ProtonKicker/Flourine/media/v1 dec 18 2024.jpg

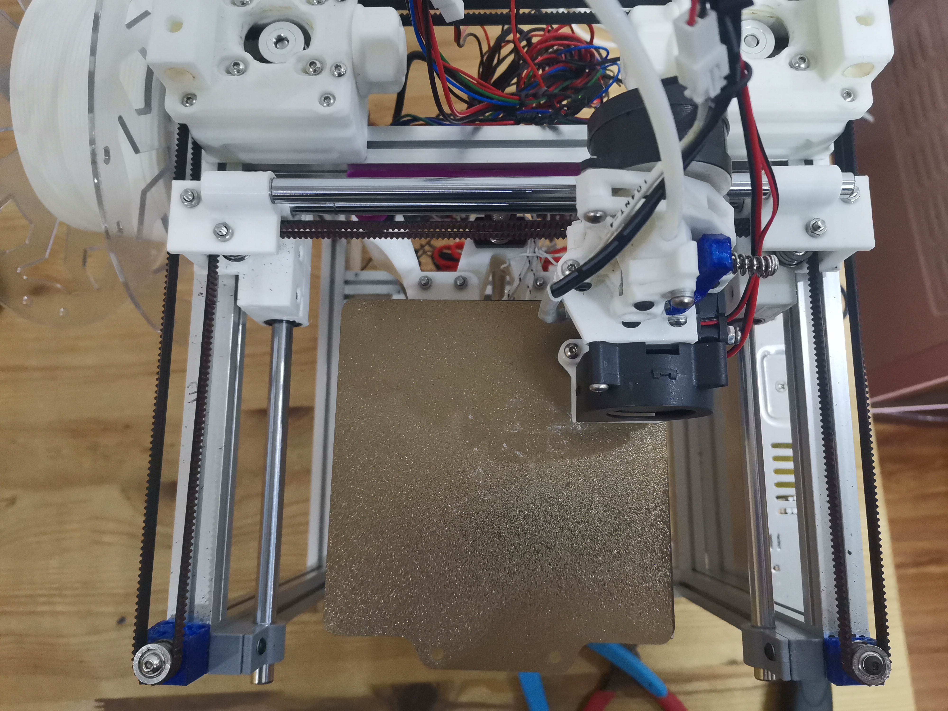
media/v1 dec 18 2024.jpg
