ProtonKicker/Flourine/media/v1 jul 18 2025.jpg

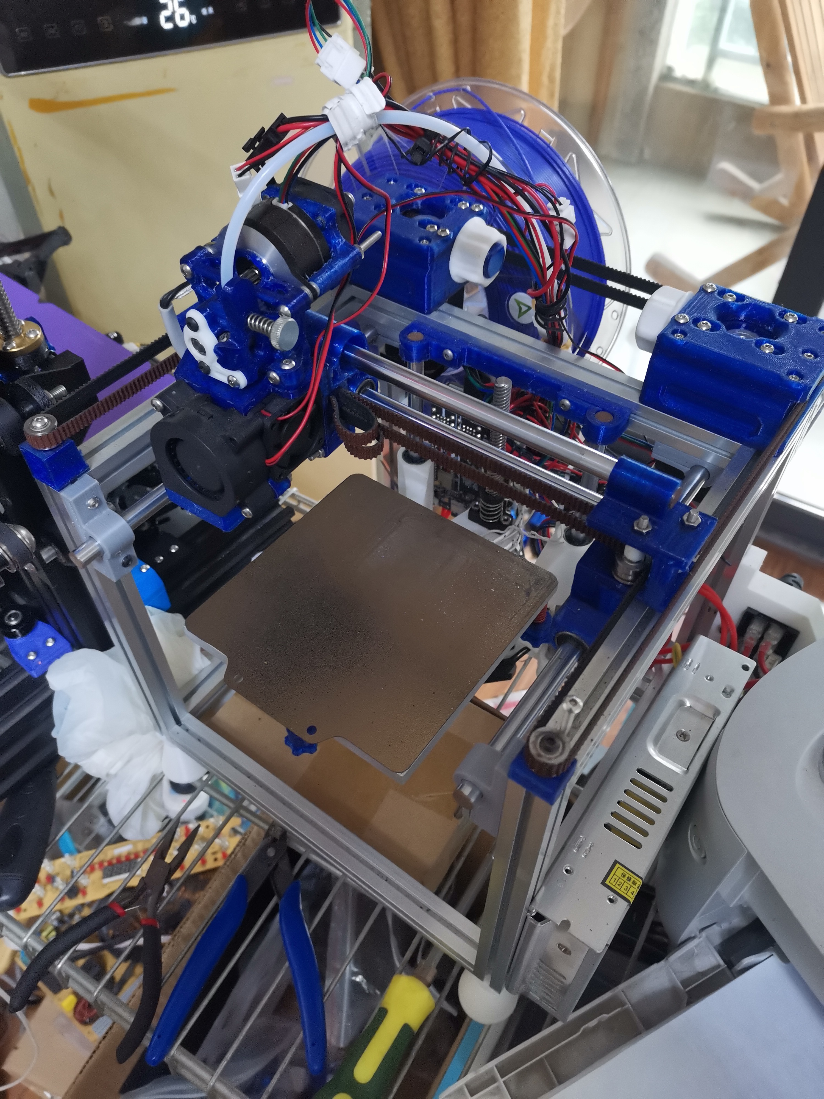
media/v1 jul 18 2025.jpg
