ProtonKicker/Flourine/siboor voron 0 motor kit specs/README.md

info about the motors I used in this build
