ProtonKicker/Flourine/hotend size (chc)/README.md

Here are the infomation for the hotend I used

Any hotend with a heatsink diameter no larger than 22mm and 4 M2.5 holes on top is fine.

You can adjust the air duct depth using the CAD files if your hotend features a different length
