ProtonKicker/Flourine/toolhead variant - orbiter v2.5/README.md

#### Oribter v2.5 Toolhead Variant

Print the adapter, update the gear ratio, and you're good to go
