ProtonKicker/Flourine/hotend size (chc)/size1.png

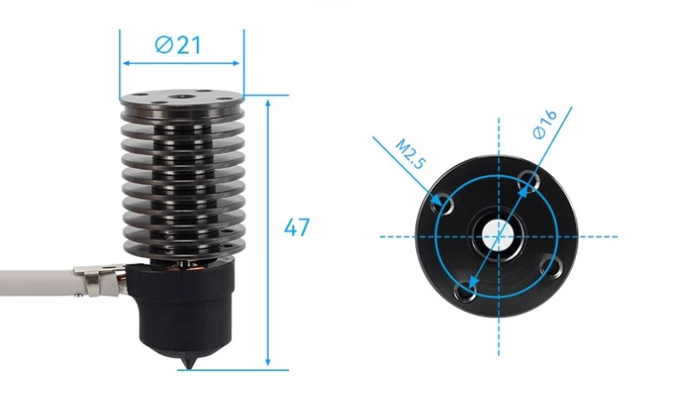
hotend size (chc)/size1.png
