ProtonKicker/Flourine/hotend size (chc)/size 2.png

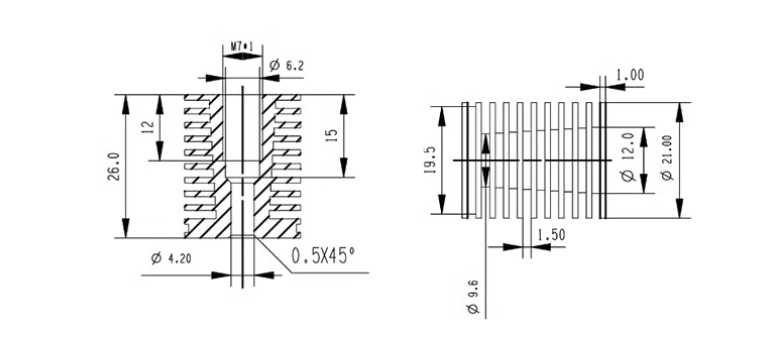
hotend size (chc)/size 2.png
