ProtonKicker/Flourine/media/v1 dec 31 2024.jpg

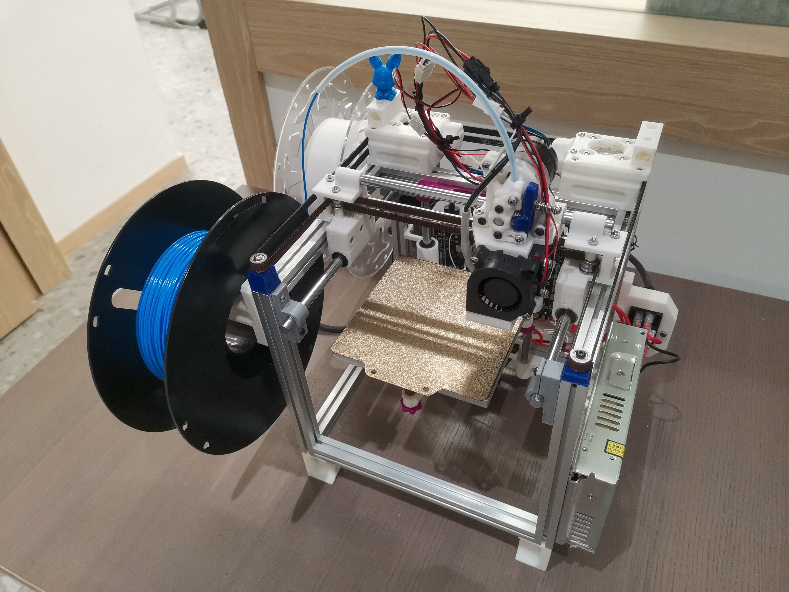
media/v1 dec 31 2024.jpg
