ProtonKicker/Flourine/media/xy motion snapshot.png

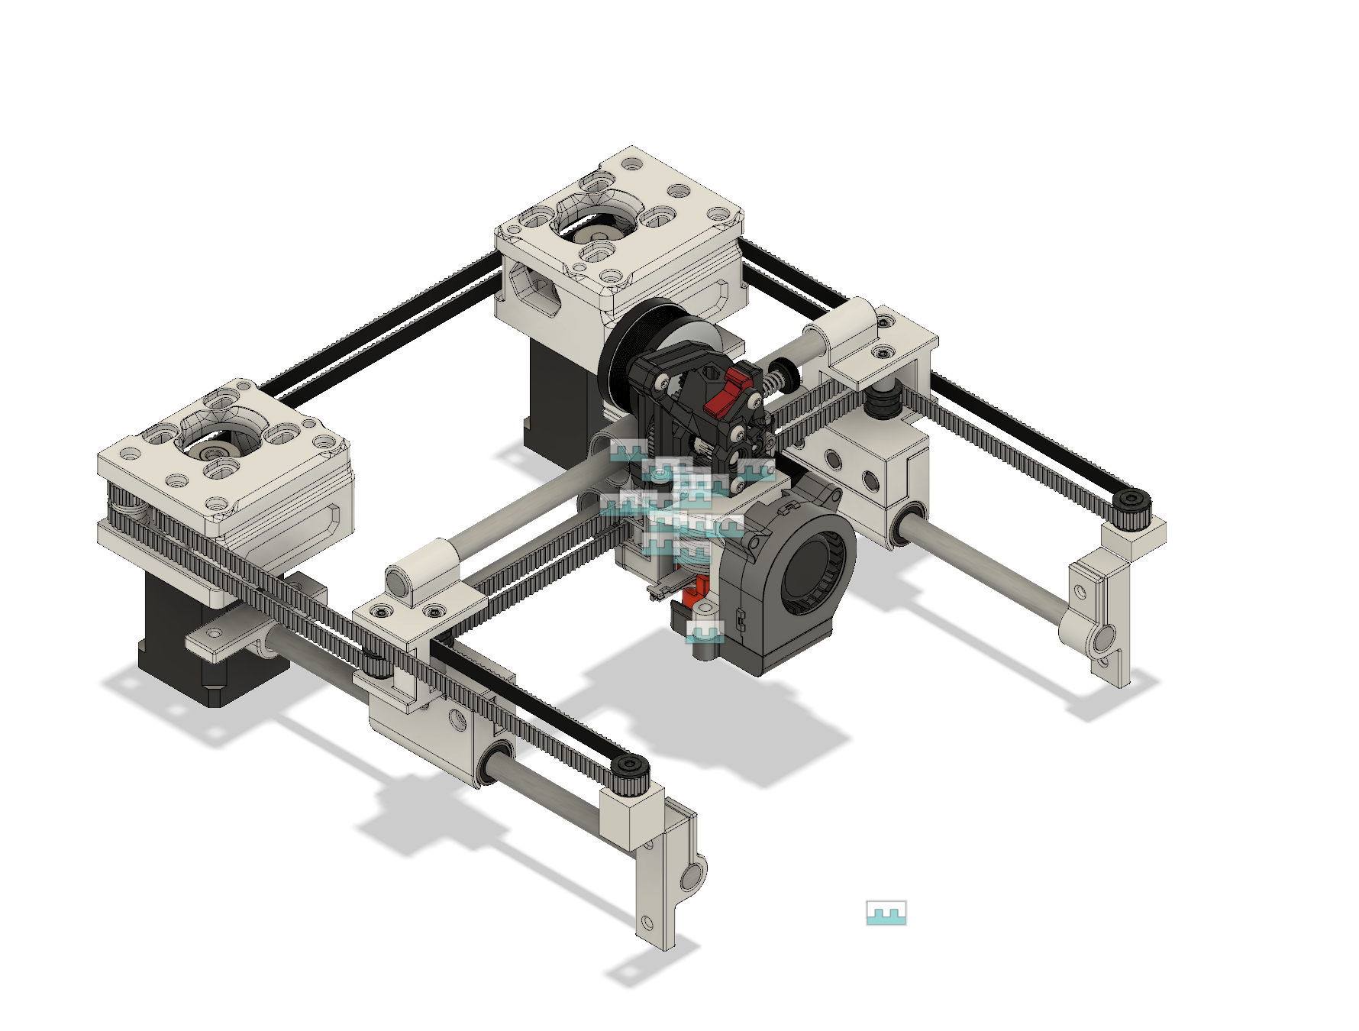
media/xy motion snapshot.png
