ProtonKicker/Flourine/siboor voron 0 motor kit specs/pancake motor.jpg

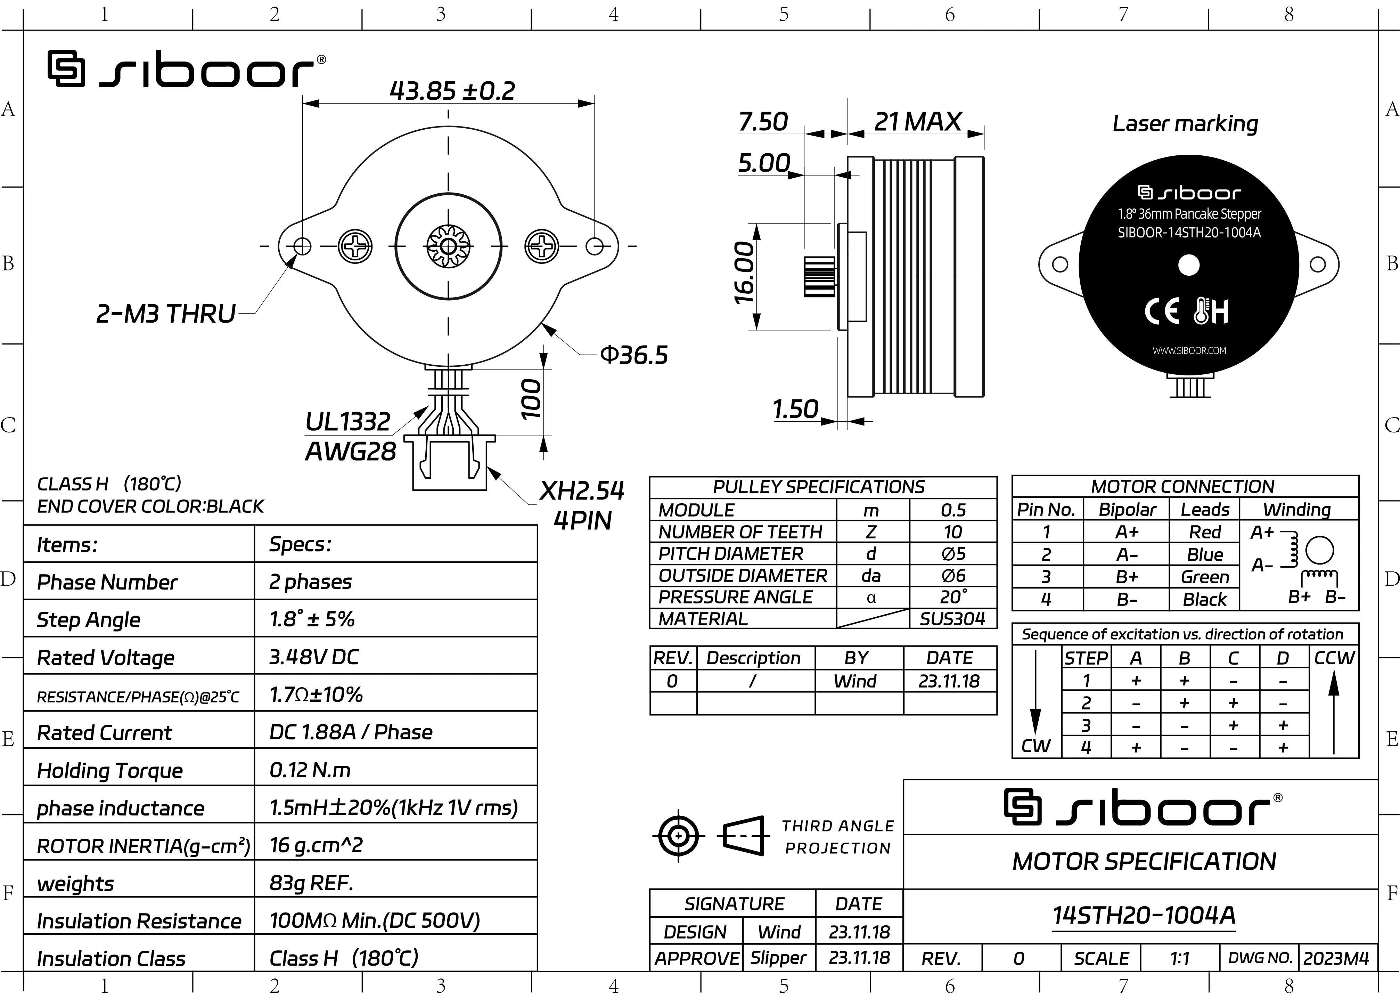
siboor voron 0 motor kit specs/pancake motor.jpg
