ProtonKicker/Flourine/siboor voron 0 motor kit specs/xy motor.jpg

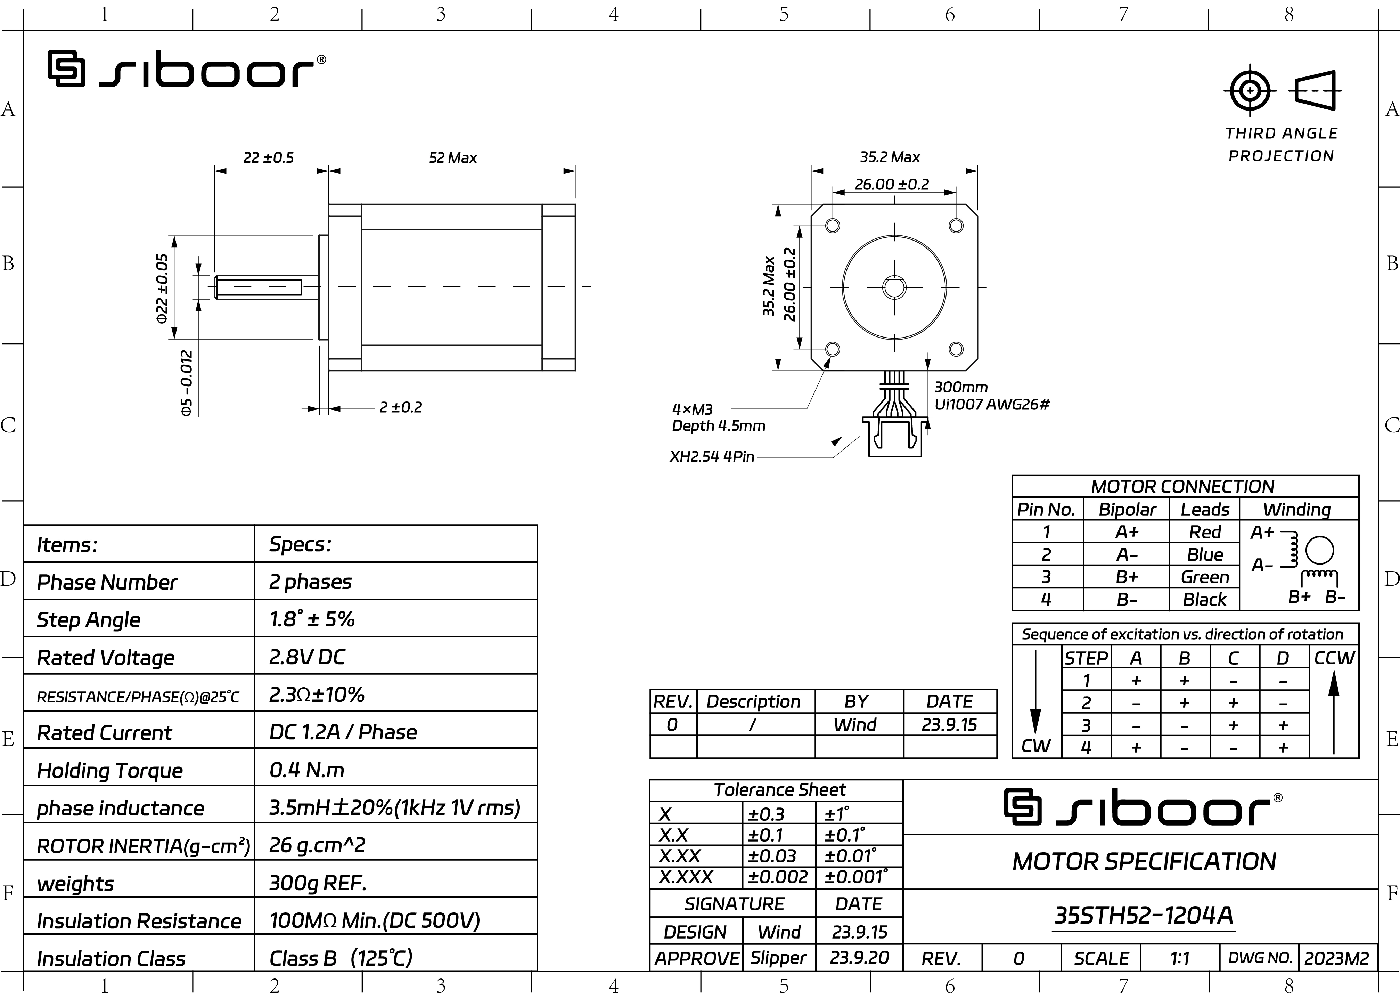
siboor voron 0 motor kit specs/xy motor.jpg
