ProtonKicker/Flourine/siboor voron 0 motor kit specs/z motor.jpg

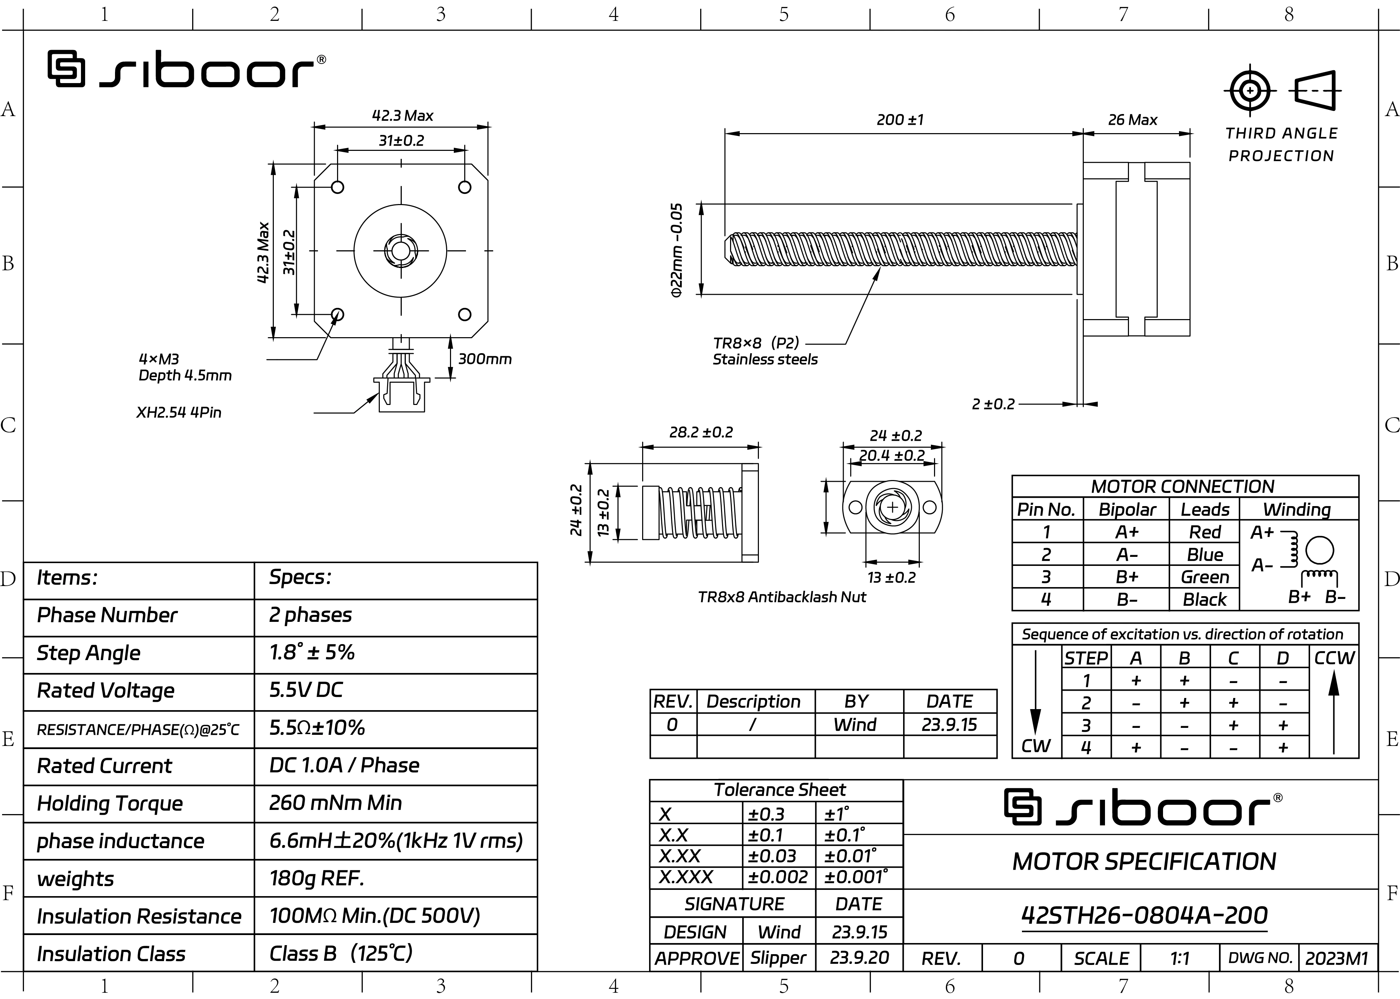
siboor voron 0 motor kit specs/z motor.jpg
