ProtonKicker/Flourine/toolhead variant - orbiter v2.5/new toolhead variant with LDO orbitor v2.5.png

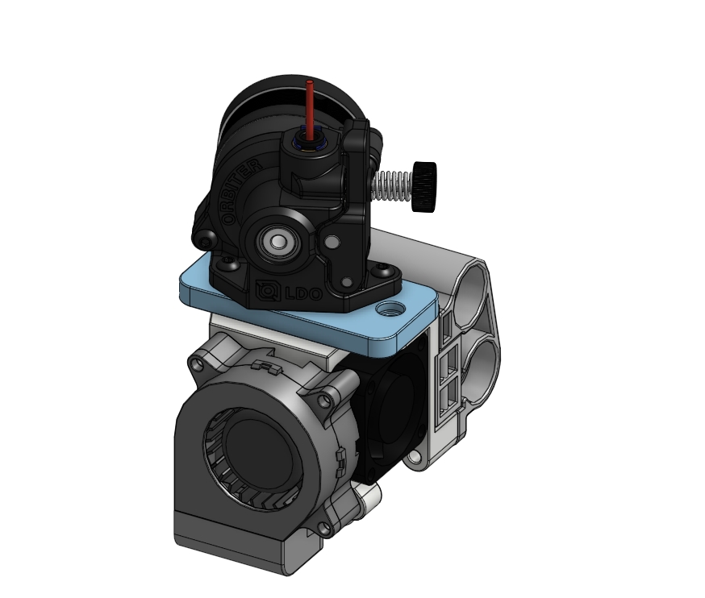
toolhead variant - orbiter v2.5/new toolhead variant with LDO orbitor v2.5.png
