ProtonKicker/Flourine/toolhead variant - orbiter v2.5/toolhead with v2.5.jpg

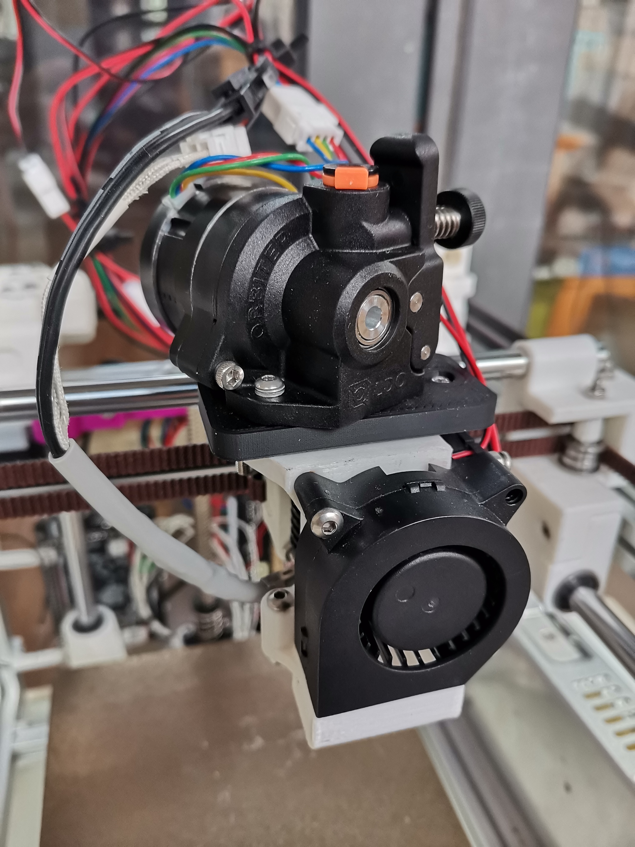
toolhead variant - orbiter v2.5/toolhead with v2.5.jpg
