ProtonKicker/Flourine/cost calculations/bills.xlsx

item name | amount | total price in CNY | percent
voron 0 extrusion kit (tapped) | 1 | 100.9 | 0.13719491467808825
extruder gear kit | 1 | 15 | 0.020395676116663267
micro switch | 10 | 2.2 | 0.002991365830443946
v6 voron hotend | 1 | 73.5 | 0.09993881297165001
skr pico & btt pi | 1 | 254 | 0.34536678224216466
sibor motor kit | 1 | 155.53 | 0.21147596709497588
sibor pancake motor extension cable | 1 | 1.49 | 0.0020259704942552177
16 awg cable | 2 meters | 2.12 | 0.0028825888911550752
steal rod 20cm | 6 | 21.5 | 0.029233802433884015
smooth rod bearing | 6 | 6.41 | 0.00871575226052077
idler bearing | 24 | 24 | 0.03263308178666123
6mm timing belt | 2 | 10.08 | 0.013705894350397716
20 tooth pulley for xy motors | 2
12*12cm glass | 1 | 7.82 | 0.010632945815487117
bed springs | 4 | 2.3 | 0.0031273370045550343
24V 4020 blower fan | 1 | 2.82 | 0.0038343871099326943
meanwell 150w power supply | 1 | 49 | 0.06662587531443334
iec c14 plug | 1 | 5.99 | 0.008144673329254198
heat shrink tubing 2mm | 5 meters | 0.79 | 0.0010741722754775988
 | total spending | 735.45
 | total spending in USD | 103.43881856540085
