ProtonKicker/Flourine/toolhead variant - orbiter v2.5/adapter print file/LDO Oribiter Extruder v2.5 to Sherpa Mini Holes Adapter.step

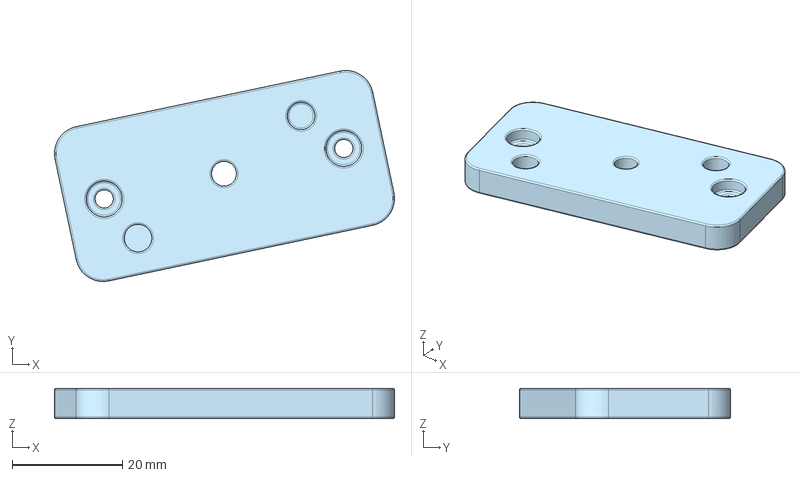
[picture p12: CAD file, 2025-01-07]
toolhead variant - orbiter v2.5/adapter print file/LDO Oribiter Extruder v2.5 to Sherpa Mini Holes Adapter.step
61.7 x 38.3 x 5.50 mm
