ProtonKicker/Flourine/(list of files, cad)

Other CAD files:
toolhead variant - orbiter v2.5/adapter print file/LDO Oribiter Extruder v2.5 to Sherpa Mini Holes Adapter.3mf
