ProtonKicker/Flourine/printer CAD/README.md

Unzip using Windows/Mac defualt zipper for the printer assembly's STEP file.
