ProtonKicker/Flourine/manual & guide/flash SKR Pico firmware-chinese.docx

1. 依次输入

cd klipper

make menuconfig

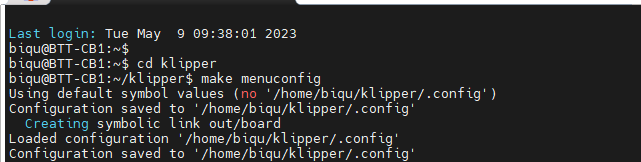
[picture p13: figure]

按照下图进行设置（usb通信）

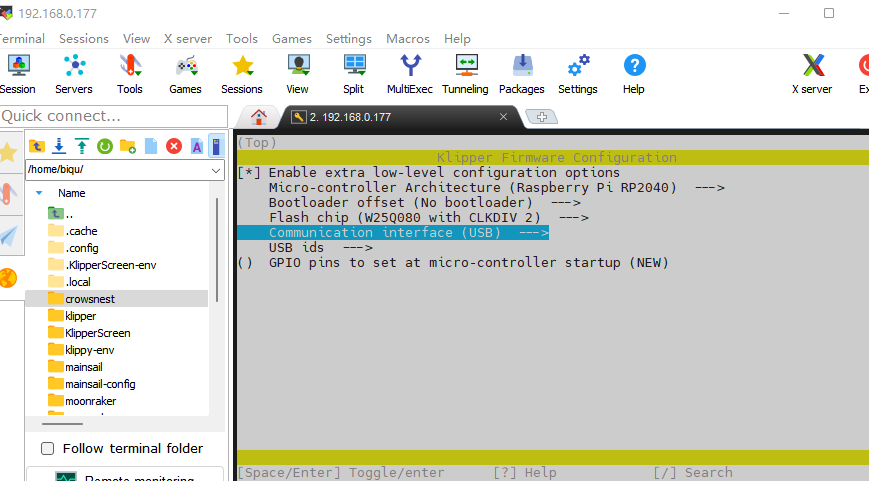
[picture p14: figure]
1683628040394_8f44064431857b506f4989d0278a1748

2.输入make命令

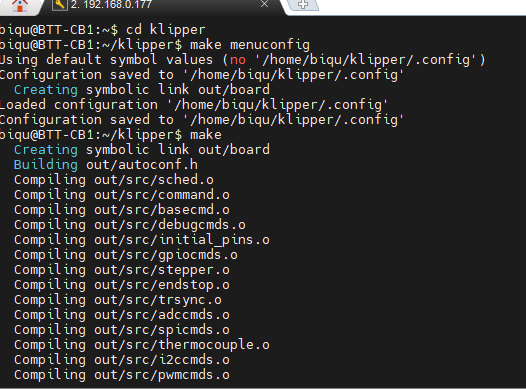
[picture p15: figure]

创建 uf2 文件 out/klipper.uf2

则表示固件编译成功。

3.然后将klipper.uf2下载到您的计算机上。

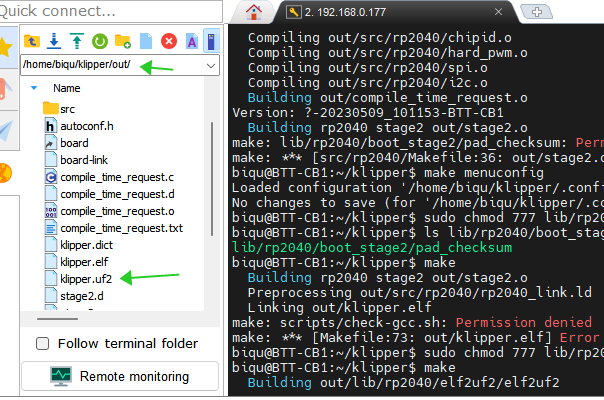
[picture p16: figure]

4.固件安装

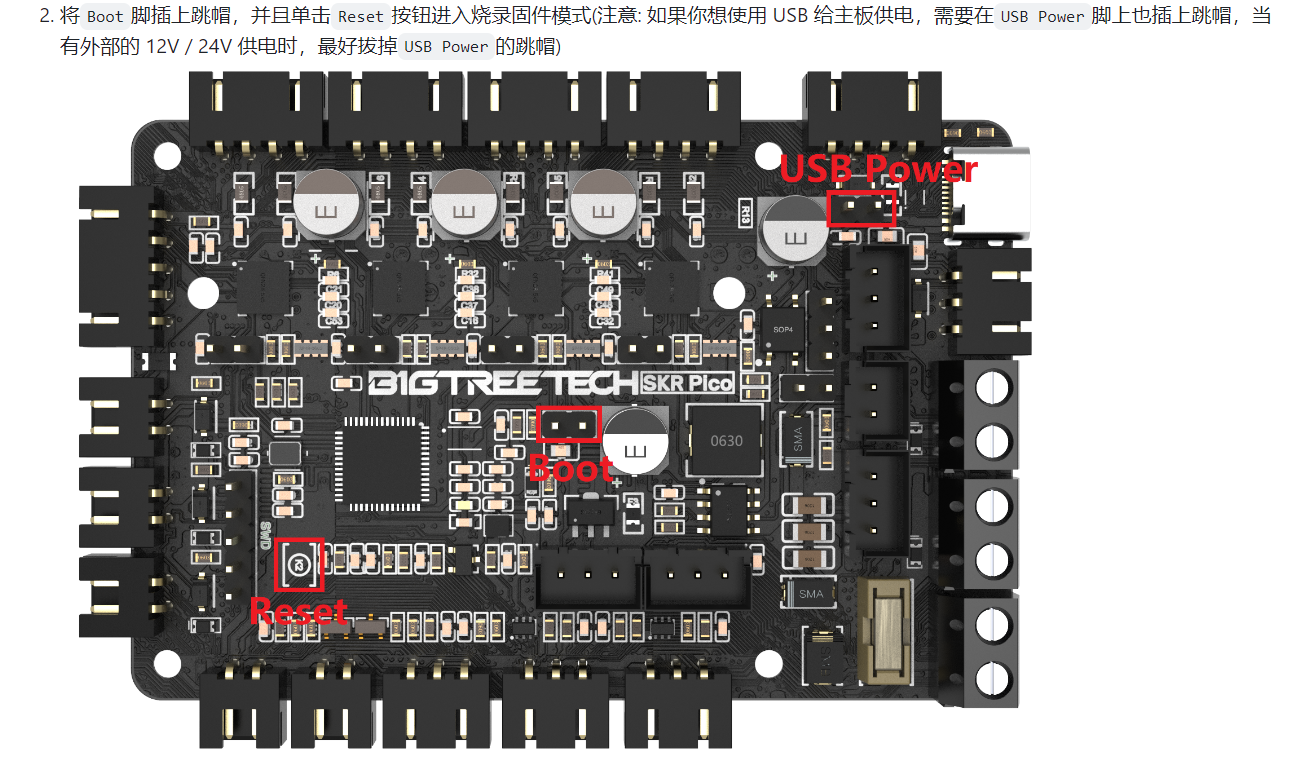
[picture p17: figure]
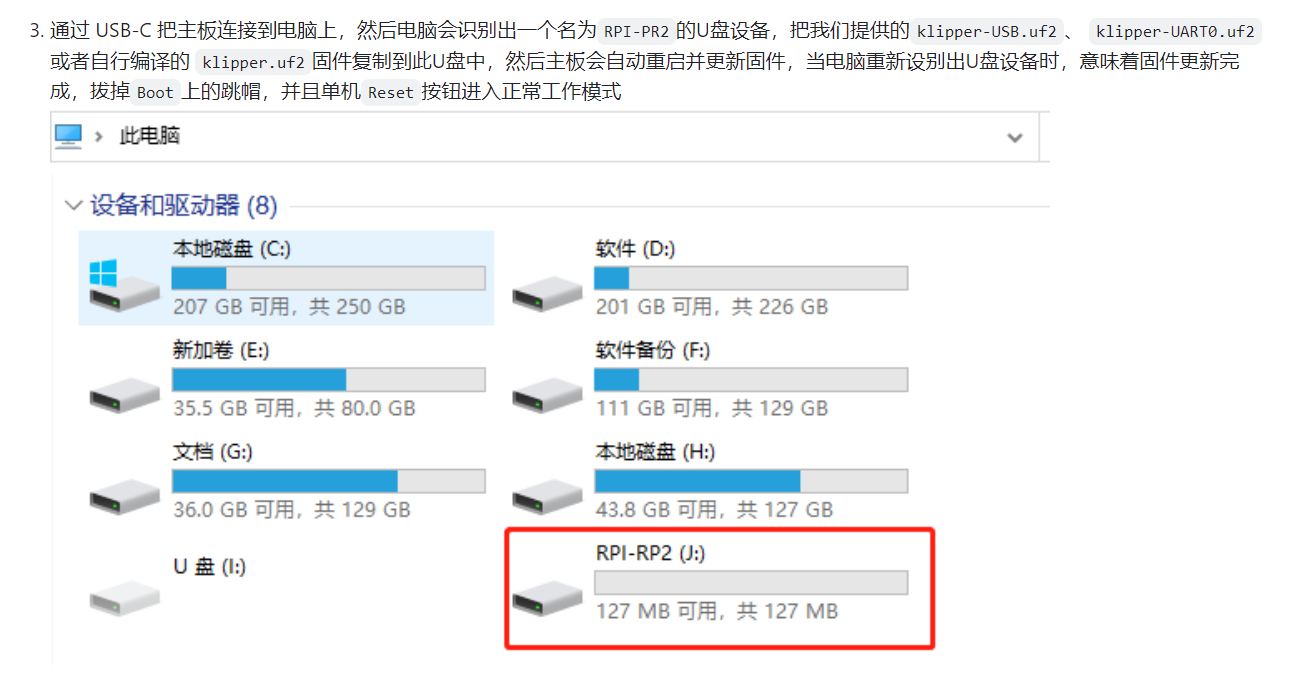
[picture p18: figure]

5.烧录成功后，skr pico拔掉boot跳线帽和usb跳线帽，上位机usb接到skr pico的typec，输入命令ls /dev/serial/by-id来查询主板的串口id（只适用于usb通信）

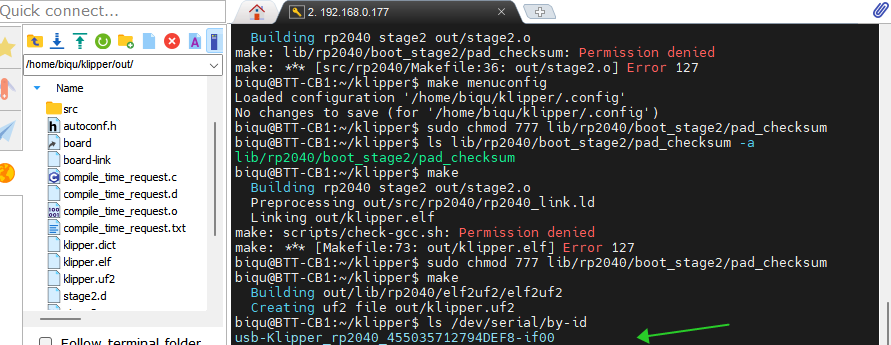
[picture p19: figure]

6.添加配置文件generic-bigtreetech-skr-pico-v1.0.cfg，并引用（include）

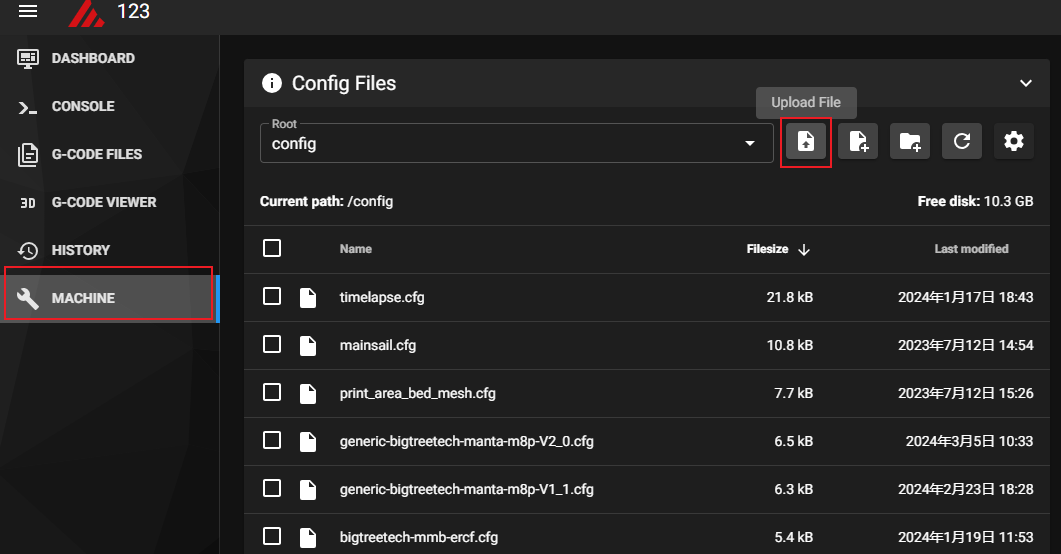
[picture p20: figure]

引用：

在添加的配置文件里找到mcu，并把对应位置改成自己找到的id
