ProtonKicker/Flourine/manual & guide/README.md

### here are the files to guide you through the build
