ProtonKicker/Flourine/manual & guide/setup BTT Pi for SKR Pico by SSH.png

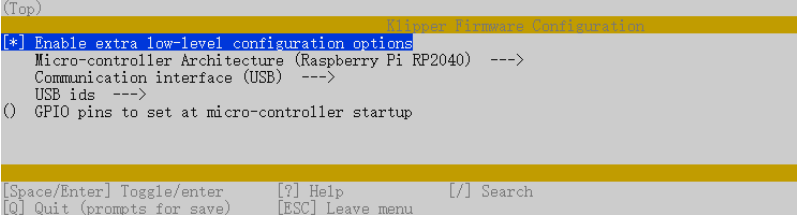
manual & guide/setup BTT Pi for SKR Pico by SSH.png
