ProtonKicker/Flourine/firmwares/printer.cfg

#[virtual_sdcard]
#path: /home/biqu/printer_data/gcodes #/home/biqu/printer_ender3neo_data/gcodes
[exclude_object]
[include mainsail.cfg]

# This file contains common pin mappings for the BIGTREETECH SKR Pico V1.0
# To use this config, the firmware should be compiled for the RP2040 with
# USB communication.

# The "make flash" command does not work on the SKR Pico V1.0. Instead,
# after running "make", copy the generated "out/klipper.uf2" file
# to the mass storage device in RP2040 boot mode

## Voron Design VORON 0.2 SKR Pico V1.0 config

## *** THINGS TO CHANGE/CHECK: ***
## MCU path                                                                     [mcu] section
## Z and Extruder motor currents                                                [tmc2209 stepper_*] sections. Uncomment the stepper motor you have
## Full steps per rotation for Extruder                                         [extruder] section
## Thermistor types                                                             [extruder] and [heater_bed] sections - See https://www.klipper3d.org/Config_Reference.html#common-thermistors for common thermistor types
## Motor currents                                                               [extruder] [stepper] and [_HOME_X/Y] macro sections
## PID tune                                                                     [extruder] and [heater_bed] sections
## Fine tune E steps                                                            [extruder] section
## For more info                                                                check https://docs.vorondesign.com/build/startup/#v0

[mcu]
#####################################################################
# Obtain definition by "ls -l /dev/serial/by-id/"
#####################################################################
serial: /dev/serial/by-id/usb-Klipper_rp2040_454741505A89CADA-if00
## serial: /dev/ttyAMA0 											# for UART connection
restart_method: command


[temperature_sensor mcu_temp]
sensor_type: temperature_mcu
min_temp: 0
max_temp: 80

[temperature_sensor raspberry_pi]
sensor_type: temperature_host
min_temp: 10
max_temp: 80

[printer]
kinematics: corexy
max_velocity: 600
max_accel: 15000
max_z_velocity: 20
max_z_accel: 200
square_corner_velocity: 6.0

#####################################################################
#      X/Y Stepper Settings
#####################################################################

[stepper_x]
step_pin: gpio11
## Refer to https://docs.vorondesign.com/build/startup/#v0
dir_pin: !gpio10                                                     # Check motor direction in link above. If inverted, add a ! before gpio10
enable_pin: !gpio12
rotation_distance: 40
microsteps: 32
full_steps_per_rotation: 200                                        # Set to 400 for 0.9° degree stepper motor, 200 is for 1.8° stepper motors
endstop_pin: tmc2209_stepper_x:virtual_endstop
position_endstop: 120
position_max: 120
homing_speed: 20                                                    # for sensorless homing it is recommended not to go above 40mm/s   
homing_retract_dist: 0
homing_positive_dir: true

[tmc2209 stepper_x]
uart_pin: gpio9
tx_pin: gpio8
uart_address: 0
interpolate: True
run_current: 0.6            
# you need to calculate the run_current value using the equation (rated_motor_current * 0.707 = Maximum_run_current) start with a value that is about 60%-70% of your maximum value.
sense_resistor: 0.110
stealthchop_threshold: 0                                            # Set to 999999 to turn stealthchop on, and 0 to use spreadcycle
diag_pin: ^gpio4    												# YOU NEED TO JUMP THIS DIAG PIN ON YOUR BOARD FOR SENSORLESS HOMING TO WORK 
driver_SGTHRS: 45  												# this is set to 255 which is the MAX sensitivity for sensorless homing, you will need to tune this later

[stepper_y]
step_pin: gpio6
## Refer to https://docs.vorondesign.com/build/startup/#v0
dir_pin: gpio5                                                      # Check motor direction in link above. If inverted, add a ! before gpio5
enable_pin: !gpio7
rotation_distance: 40
microsteps: 32
full_steps_per_rotation: 200                                        # Set to 400 for 0.9° degree stepper motor, 200 is for 1.8° stepper motors
endstop_pin: tmc2209_stepper_y:virtual_endstop
position_endstop: 115
position_max: 120
homing_speed: 20                                                    # for sensorless homing it is recommended not to go above 40mm/s   
homing_retract_dist: 0
homing_positive_dir: true

[tmc2209 stepper_y]
uart_pin: gpio9
tx_pin: gpio8
uart_address: 2
interpolate: True
run_current: 0.6            
# you need to calculate the run_current value using the equation (rated_motor_current * 0.707 = Maximum_run_current) start with a value that is about 60%-70% of your maximum value.
sense_resistor: 0.110
stealthchop_threshold: 0                                            # Set to 999999 to turn stealthchop on, and 0 to use spreadcycle
diag_pin: ^gpio3    												# YOU NEED TO JUMP THIS DIAG PIN ON YOUR BOARD FOR SENSORLESS HOMING TO WORK 
driver_SGTHRS: 60										# this is set to 255 which is the MAX sensitivity for sensorless homing, you will need to tune this later

#####################################################################
#   Z Stepper Settings
#####################################################################

[stepper_z]
step_pin: gpio19
dir_pin: !gpio28                                                    # Remove the ! before gpio28 if motor direction is inverted.
enable_pin: !gpio2
rotation_distance: 8                                                # For T8x8 integrated lead screw
microsteps: 32
endstop_pin: ^gpio25
position_endstop: 100.25
position_max: 130
position_min: 0
homing_speed: 15
second_homing_speed: 3.0
homing_retract_dist: 3.0


[tmc2209 stepper_z]
uart_pin: gpio9
tx_pin: gpio8
uart_address: 1
interpolate: True
## For OMC (StepperOnline) 17LS13-0404E-200G 0.4A 
#run_current: 0.2
## For LDO-42STH25-1004CL200E 1.0A
#run_current: 0.37
run_current: 0.6
sense_resistor: 0.110
stealthchop_threshold: 0                                            # Set to 999999 to turn stealthchop on, and 0 to use spreadcycle

#####################################################################
#   Extruder
#####################################################################

[extruder]
step_pin: gpio14
dir_pin: !gpio13                                                     # Add ! if moving opposite direction
enable_pin: !gpio15
full_steps_per_rotation: 200                                       # Set to 200 for LDO 1.8° stepper motor, and set to 400 for OMC(StepperOnline) 0.9° stepper motor
rotation_distance: 22.23                                            # See calibrating rotation_distance on extruders doc
gear_ratio: 50:10                                                   # For Mini Afterburner
microsteps: 32
nozzle_diameter: 0.400
filament_diameter: 1.750
heater_pin: gpio23
sensor_type: Generic 3950
sensor_pin: gpio27
control: pid                                                        # Do PID calibration after initial checks
pid_Kp: 28.182
pid_Ki: 1.978
pid_Kd: 100.397
min_temp: 0
max_temp: 320
min_extrude_temp: 190
max_extrude_only_distance: 150
max_extrude_cross_section: 0.8
pressure_advance: 0.0                                               # See tuning pressure advance doc
pressure_advance_smooth_time: 0.040

[tmc2209 extruder]
uart_pin: gpio9
tx_pin: gpio8
uart_address: 3
interpolate: True
## For OMC (StepperOnline) 14HR07-1004VRN 1A 0.9°
#run_current: 0.5 # for OMC 14HR07-1004VRN rated at 1A
## For LDO LDO 36STH17-1004AHG 1A 1.8° 
#run_current: 0.3 # for LDO 36STH17-1004AHG
## For LDO LDO 36STH20-1004AHG 1A 1.8° 
#run_current: 0.6 # for LDO 36STH20-1004AHG
run_current: 0.55
sense_resistor: 0.110
stealthchop_threshold: 0                                            # Set to 0 for spreadcycle, avoid using stealthchop on extruder

#####################################################################
#   Bed Heater
#####################################################################

[heater_bed]
heater_pin: gpio21                  # Ensure this matches your wiring

## Using NTC100K sensor, same as the extruder
sensor_type: Generic 3950 # Common NTC100K thermistor type

sensor_pin: gpio26                  # Ensure this matches your wiring
smooth_time: 3.0                    # Adjust as needed

max_power: 0.7                     

min_temp: 0
max_temp: 120
control: pid                        # Do PID calibration after initial checks
pid_kp: 68.453                      # Adjust based on PID tuning
pid_ki: 2.749                       # Adjust based on PID tuning
pid_kd: 426.122                     # Adjust based on PID tuning


#####################################################################
# Fan Control
#####################################################################

[heater_fan hotend_fan]
pin: gpio18
max_power: 1.0
kick_start_time: 0.5
heater: extruder
heater_temp: 30
fan_speed: 1.0                                                     # You can't PWM the delta fan unless using blue wire

[fan]
pin: gpio17
max_power: 1.0
kick_start_time: 0.5                                                # Depending on your fan, you may need to increase this value if your fan will not start
off_below: 0.13
cycle_time: 0.010

[output_pin controller_board_fan]
# Fan connected to GPIO20, configured to be always on when MCU is powered.
pin: gpio20
pwm: False        # Set to True if your fan is PWM controllable and you need speed control, otherwise False for simple on/off. Always-on usually means False.
value: 1          # Set to 1 (ON) by default.
shutdown_value: 0 # Turn OFF when Klipper enters shutdown state.

#####################################################################
#   Filament Runout Sensor
#####################################################################

#[filament_switch_sensor Filament_Runout_Sensor]
#pause_on_runout: True
#runout_gcode: PAUSE
#switch_pin: gpio16

#####################################################################
# Homing and Gantry Adjustment Routines
#####################################################################

[idle_timeout]
timeout: 1800

[homing_override]
axes: xyz
set_position_z: 0
gcode:
   G90
   G0 Z5 F600
  {% set home_all = 'X' not in params and 'Y' not in params and 'Z' not in params %}

  {% if home_all or 'X' in params %}
    _HOME_X
  {% endif %}
  
  {% if home_all or 'Y' in params %}
    _HOME_Y
  {% endif %}
  
  {% if home_all or 'Z' in params %}
    _HOME_Z
  {% endif %}

#[safe_z_home]
##home_xy_position: 120,120 										# these coordinates must NOT be greater than the values specified in "position_max:" for the X and Y steppers
#speed: 50.0
#z_hop: 5

## To be used with BED_SCREWS_ADJUST
[bed_screws]
screw1: 60,5
screw1_name: front screw
screw2: 5,115
screw2_name: back left
screw3: 115,115
screw3_name: back right

#####################################################################
# Neopixel
#####################################################################

[neopixel board_rgb]
pin: gpio24
chain_count: 1
color_order: GRB
initial_RED: 0.0
initial_GREEN: 0.1
initial_BLUE: 0.0

#####################################################################
#   V0 Display
#####################################################################
# [mcu display]
# serial: **PASTE YOUR SERIAL PORT HERE AND UNCOMMENT**
# restart_method: command

# [display]
# lcd_type: sh1106
# i2c_mcu: display
# i2c_bus: i2c1a
# # Set the direction of the encoder wheel
# #   Standard: Right (clockwise) scrolls down or increases values. Left (counter-clockwise scrolls up or decreases values.
# encoder_pins: ^display:PA3, ^display:PA4
# #   Reversed: Right (clockwise) scrolls up or decreases values. Left (counter-clockwise scrolls down or increases values.
# #encoder_pins: ^display:PA4, ^display:PA3
# click_pin: ^!display:PA1
# kill_pin: ^!display:PA5
# #x_offset: 2
# #   Use X offset to shift the display towards the right. Value can be 0 to 3
# #vcomh: 0
# #   Set the Vcomh value on SSD1306/SH1106 displays. This value is
# #   associated with a "smearing" effect on some OLED displays. The
# #   value may range from 0 to 63. Default is 0.
# #   Adjust this value if you get some vertical stripes on your display. (31 seems to be a good value)

# [neopixel displayStatus]
# pin: display:PA0
# chain_count: 1
# color_order: GRB
# initial_RED: 0.2
# initial_GREEN: 0.05
# initial_BLUE: 0

#####################################################################
# Macros
#####################################################################

[gcode_macro PRINT_START]
#   Use PRINT_START for the slicer starting script - please customize for your slicer of choice
gcode:
    G28                            ; home all axes
    G90                            ; absolute positioning    
    G1 Z20 F3000                   ; move nozzle away from bed
   
[gcode_macro PRINT_END]
#   Use PRINT_END for the slicer ending script - please customize for your slicer of choice
gcode:
    M400                           ; wait for buffer to clear
    G92 E0                         ; zero the extruder
    G1 E-4.0 F3600                 ; retract filament
    G91                            ; relative positioning

    #   Get Boundaries
    {% set max_x = printer.configfile.config["stepper_x"]["position_max"]|float %}
    {% set max_y = printer.configfile.config["stepper_y"]["position_max"]|float %}
    {% set max_z = printer.configfile.config["stepper_z"]["position_max"]|float %}

    #   Check end position to determine safe direction to move
    {% if printer.toolhead.position.x < (max_x - 20) %}
        {% set x_safe = 20.0 %}
    {% else %}
        {% set x_safe = -20.0 %}
    {% endif %}

    {% if printer.toolhead.position.y < (max_y - 20) %}
        {% set y_safe = 20.0 %}
    {% else %}
        {% set y_safe = -20.0 %}
    {% endif %}

    {% if printer.toolhead.position.z < (max_z - 2) %}
        {% set z_safe = 2.0 %}
    {% else %}
        {% set z_safe = max_z - printer.toolhead.position.z %}
    {% endif %}

    G0 Z{z_safe} F3600             ; move nozzle up
    G0 X{x_safe} Y{y_safe} F20000  ; move nozzle to remove stringing
    TURN_OFF_HEATERS
    M107                           ; turn off fan
    G90                            ; absolute positioning
    G0 X60 Y{max_y-10} F3600          ; park nozzle at rear
  
[gcode_macro LOAD_FILAMENT]
gcode:
   M83                            ; set extruder to relative
   G1 E30 F300                    ; load
   G1 E15 F150                    ; prime nozzle with filament
   M82                            ; set extruder to absolute

[gcode_macro TEST_EXTRUDER_MOTOR]
gcode:
   M83                            ; set extruder to relative
   G1 E50 F150                    ; prime nozzle with filament
   M82                            ; set extruder to absolute

[gcode_macro UNLOAD_FILAMENT]
gcode:
   M83                            ; set extruder to relative
   G1 E10 F300                    ; extrude a little to soften tip
   G1 E-40 F1800                  ; retract some, but not too much or it will jam
   M82                            ; set extruder to absolute

[gcode_macro _HOME_X]
gcode:
    # Always use consistent run_current on A/B steppers during sensorless homing
    {% set RUN_CURRENT_X = printer.configfile.settings['tmc2209 stepper_x'].run_current|float %}
    {% set RUN_CURRENT_Y = printer.configfile.settings['tmc2209 stepper_y'].run_current|float %}
    {% set HOME_CURRENT_RATIO = 0.7 %} # by default we are dropping the motor current during homing. you can adjust this value if you are having trouble with skipping while homing
    SET_TMC_CURRENT STEPPER=stepper_x CURRENT={HOME_CURRENT_RATIO * RUN_CURRENT_X}
    SET_TMC_CURRENT STEPPER=stepper_y CURRENT={HOME_CURRENT_RATIO * RUN_CURRENT_Y}

    # Home
    G28 X
    # Move away
    G91
    G1 X-10 F1200
    
    # Wait for StallGuard registers to clear
    M400
    G90
    # Set current during print
    SET_TMC_CURRENT STEPPER=stepper_x CURRENT={RUN_CURRENT_X}
    SET_TMC_CURRENT STEPPER=stepper_y CURRENT={RUN_CURRENT_Y}

[gcode_macro _HOME_Y]
gcode:
    # Set current for sensorless homing
    {% set RUN_CURRENT_X = printer.configfile.settings['tmc2209 stepper_x'].run_current|float %}
    {% set RUN_CURRENT_Y = printer.configfile.settings['tmc2209 stepper_y'].run_current|float %}
    {% set HOME_CURRENT_RATIO = 0.7 %} # by default we are dropping the motor current during homing. you can adjust this value if you are having trouble with skipping while homing
    SET_TMC_CURRENT STEPPER=stepper_x CURRENT={HOME_CURRENT_RATIO * RUN_CURRENT_X}
    SET_TMC_CURRENT STEPPER=stepper_y CURRENT={HOME_CURRENT_RATIO * RUN_CURRENT_Y}

    # Home
    G28 Y
    # Move away
    G91
    G1 Y-10 F1200

    # Wait for StallGuard registers to clear
    M400
    G90
    # Set current during print
    SET_TMC_CURRENT STEPPER=stepper_x CURRENT={RUN_CURRENT_X}
    SET_TMC_CURRENT STEPPER=stepper_y CURRENT={RUN_CURRENT_Y}

[gcode_macro _HOME_Z]
gcode:
    G90
    G28 Z
    G1 Z30


# see if this works

[gcode_macro TEST_SPEED]
# Home, get position, throw around toolhead, home again.
# If MCU stepper positions (first line in GET_POSITION) are greater than a full step different (your number of microsteps), then skipping occured.
# We only measure to a full step to accomodate for endstop variance.
# Example: TEST_SPEED SPEED=300 ACCEL=5000 ITERATIONS=10

description: Test for max speed and acceleration parameters for the printer. Procedure: Home -> ReadPositionFromMCU -> MovesToolhead@Vel&Accel -> Home -> ReadPositionfromMCU

gcode:
    # Speed
    {% set speed  = params.SPEED|default(printer.configfile.settings.printer.max_velocity)|int %}
    # Iterations
    {% set iterations = params.ITERATIONS|default(5)|int %}
    # Acceleration
    {% set accel  = params.ACCEL|default(printer.configfile.settings.printer.max_accel)|int %}
    # Minimum Cruise Ratio
    {% set min_cruise_ratio = params.MIN_CRUISE_RATIO|default(0.5)|float %}
    # Bounding inset for large pattern (helps prevent slamming the toolhead into the sides after small skips, and helps to account for machines with imperfectly set dimensions)
    {% set bound = params.BOUND|default(20)|int %}
    # Size for small pattern box
    {% set smallpatternsize = SMALLPATTERNSIZE|default(20)|int %}
    
    # Large pattern
        # Max positions, inset by BOUND
        {% set x_min = printer.toolhead.axis_minimum.x + bound %}
        {% set x_max = printer.toolhead.axis_maximum.x - bound %}
        {% set y_min = printer.toolhead.axis_minimum.y + bound %}
        {% set y_max = printer.toolhead.axis_maximum.y - bound %}
    
    # Small pattern at center
        # Find X/Y center point
        {% set x_center = (printer.toolhead.axis_minimum.x|float + printer.toolhead.axis_maximum.x|float ) / 2 %}
        {% set y_center = (printer.toolhead.axis_minimum.y|float + printer.toolhead.axis_maximum.y|float ) / 2 %}
        
        # Set small pattern box around center point
        {% set x_center_min = x_center - (smallpatternsize/2) %}
        {% set x_center_max = x_center + (smallpatternsize/2) %}
        {% set y_center_min = y_center - (smallpatternsize/2) %}
        {% set y_center_max = y_center + (smallpatternsize/2) %}

    # Save current gcode state (absolute/relative, etc)
    SAVE_GCODE_STATE NAME=TEST_SPEED
    
    # Output parameters to g-code terminal
    { action_respond_info("TEST_SPEED: starting %d iterations at speed %d, accel %d" % (iterations, speed, accel)) }
    
    # Home and get position for comparison later:
        M400 # Finish moves - https://github.com/AndrewEllis93/Print-Tuning-Guide/issues/66
        G28
        # QGL if not already QGLd (only if QGL section exists in config)
        {% if printer.configfile.settings.quad_gantry_level %}
            {% if printer.quad_gantry_level.applied == False %}
                QUAD_GANTRY_LEVEL
                G28 Z
            {% endif %}
        {% endif %} 
        # Move 50mm away from max position and home again (to help with hall effect endstop accuracy - https://github.com/AndrewEllis93/Print-Tuning-Guide/issues/24)
        G90
        G1 X{printer.toolhead.axis_maximum.x-50} Y{printer.toolhead.axis_maximum.y-50} F{30*60}
        M400 # Finish moves - https://github.com/AndrewEllis93/Print-Tuning-Guide/issues/66
        G28 X Y
        G0 X{printer.toolhead.axis_maximum.x-1} Y{printer.toolhead.axis_maximum.y-1} F{30*60}
        G4 P1000 
        GET_POSITION

    # Go to starting position
    G0 X{x_min} Y{y_min} Z{bound + 10} F{speed*60}

    # Set new limits
    {% if printer.configfile.settings.printer.minimum_cruise_ratio is defined %}
        SET_VELOCITY_LIMIT VELOCITY={speed} ACCEL={accel} MINIMUM_CRUISE_RATIO={min_cruise_ratio}
    {% else %}
        SET_VELOCITY_LIMIT VELOCITY={speed} ACCEL={accel} ACCEL_TO_DECEL={accel / 2}
    {% endif %}

    {% for i in range(iterations) %}
        # Large pattern diagonals
        G0 X{x_min} Y{y_min} F{speed*60}
        G0 X{x_max} Y{y_max} F{speed*60}
        G0 X{x_min} Y{y_min} F{speed*60}
        G0 X{x_max} Y{y_min} F{speed*60}
        G0 X{x_min} Y{y_max} F{speed*60}
        G0 X{x_max} Y{y_min} F{speed*60}
        
        # Large pattern box
        G0 X{x_min} Y{y_min} F{speed*60}
        G0 X{x_min} Y{y_max} F{speed*60}
        G0 X{x_max} Y{y_max} F{speed*60}
        G0 X{x_max} Y{y_min} F{speed*60}
    
        # Small pattern diagonals
        G0 X{x_center_min} Y{y_center_min} F{speed*60}
        G0 X{x_center_max} Y{y_center_max} F{speed*60}
        G0 X{x_center_min} Y{y_center_min} F{speed*60}
        G0 X{x_center_max} Y{y_center_min} F{speed*60}
        G0 X{x_center_min} Y{y_center_max} F{speed*60}
        G0 X{x_center_max} Y{y_center_min} F{speed*60}
        
        # Small pattern box
        G0 X{x_center_min} Y{y_center_min} F{speed*60}
        G0 X{x_center_min} Y{y_center_max} F{speed*60}
        G0 X{x_center_max} Y{y_center_max} F{speed*60}
        G0 X{x_center_max} Y{y_center_min} F{speed*60}
    {% endfor %}

    # Restore max speed/accel/accel_to_decel to their configured values
    {% if printer.configfile.settings.printer.minimum_cruise_ratio is defined %}
        SET_VELOCITY_LIMIT VELOCITY={printer.configfile.settings.printer.max_velocity} ACCEL={printer.configfile.settings.printer.max_accel} MINIMUM_CRUISE_RATIO={printer.configfile.settings.printer.minimum_cruise_ratio} 
    {% else %}
        SET_VELOCITY_LIMIT VELOCITY={printer.configfile.settings.printer.max_velocity} ACCEL={printer.configfile.settings.printer.max_accel} ACCEL_TO_DECEL={printer.configfile.settings.printer.max_accel_to_decel}
    {% endif %}

    # Re-home and get position again for comparison:
        M400 # Finish moves - https://github.com/AndrewEllis93/Print-Tuning-Guide/issues/66
        G28 # This is a full G28 to fix an issue with CoreXZ - https://github.com/AndrewEllis93/Print-Tuning-Guide/issues/12
        # Go to XY home positions (in case your homing override leaves it elsewhere)
        G90
        G0 X{printer.toolhead.axis_maximum.x-1} Y{printer.toolhead.axis_maximum.y-1} F{30*60}
        G4 P1000 
        GET_POSITION

    # Restore previous gcode state (absolute/relative, etc)
    RESTORE_GCODE_STATE NAME=TEST_SPEED

    

#*# <---------------------- SAVE_CONFIG ---------------------->
#*# DO NOT EDIT THIS BLOCK OR BELOW. The contents are auto-generated.
#*#
#*# [stepper_z]
#*# position_endstop = 130.200






#*# <---------------------- SAVE_CONFIG ---------------------->
#*# DO NOT EDIT THIS BLOCK OR BELOW. The contents are auto-generated.
#*#
#*# [stepper_z]
#*# position_endstop = 120.300
