ProtonKicker/Flourine/(commit log)

2024-08-29 upload CAD files (step+f3d format)
2024-08-29 upload printer.cfg file
    [printer.cfg]
2024-08-29 added excel specifying the cost of printer
    [bills.xlsx]
2024-08-31 update x axis smooth rod joints
2024-09-07 update printer CAD
    - renamed components
    - upgraded x gantry joints
    - organized components
2024-09-07 created folder: info for setting up firmware
    [printer.cfg]
2024-09-07 add siboor motor specs
2024-09-09 add voron assembly manual + renamed folder
    [printer.cfg]
2024-09-21 renamed file + add skr pico firmware flashing guide
2024-11-07 update CAD
    upgraded:
    - toolhead
    - x gantry
2024-11-09 update printer intro
2024-11-09 add instructions in printer.cfg
    [printer.cfg]
2024-11-09 now using stock heated bed
2024-11-10 suggested using inductive sensor in the future
2024-11-10 specified a new bed gantry
2024-11-21 update printer CAD
    upgraded toolhead cooling
2024-12-02 update CAD to stable version
    this version is recommended, managing to run long times with minimal issue (compared with previous versions)
2024-12-02 update readme for stable version relseasse
    coresponding to v421 CAD release
2024-12-18 Update printer.cfg
    updated to fit hte new CAD
    [printer.cfg]
2024-12-18 update max bed heater power
    [printer.cfg]
2024-12-18 update full cad
2024-12-18 add print profile for orca slicer
2024-12-18 add system.cfg file for btt pi
    [printer.cfg, system.cfg]
2024-12-18 add network switching tool
    by le chat mistral ai
2024-12-19 update orca print profile
2024-12-20 update firmware guide
    [system.cfg]
2025-01-07 add new orbiter extruder variant folder
    [printer copy.cfg]
2025-01-07 add print files for orbiter variant
    [LDO Oribiter Extruder v2.5 to Sherpa Mini Holes Adapter.3mf, LDO Oribiter Extruder v2.5 to Sherpa Mini Holes Adapter.step, printer.cfg]
2025-03-17 add new version cad
2025-05-01 updated motions system capabilities~
    [printer.cfg]
2025-07-18 take a pic of the printer today
